mohit1631/Substation-132-33kV-Design/Substation_132_33kV_Design.xlsx

Sheet: Summary
132/33 kV substation: design summary
Links to the calculation sheets. Change Inputs to resize.
Item | Result | Unit
Design load (N-1, with growth) | 49.0 | MVA
Transformers | 2 x 50 MVA, 132/33 kV, YNd11, Z 12.5%
Transformer loading, normal / N-1 now / N-1 design | 41% / 82% / 98%
Rated current 132 kV / 33 kV | 219 A / 875 A
Fault level 132 kV bus | 17.5 | kA
Fault level 33 kV bus (coupler closed / open) | 12.9 / 7.1 | kA
Breaker ratings 132 kV / 33 kV | 31.5 / 25 | kA
Busbars 132 kV / 33 kV | 1250 / 1250 | A
CT ratios: line / transformer HV / incomer / feeder | 600 / 300 / 1200 / 200 | A / 1 A
Arresters 132 kV / 33 kV | 120 / 36 | kV
NGR | 63.5 ohm, 300 A
Earth grid resistance | 0.73 | ohm
Ground potential rise | 9294.209668 | V
Touch voltage: Em vs tolerable | 621 vs 706 | V
Design checks
Check | Status
Transformer N-1 loading at design load <= 100% | OK
Breaker rating >= 132 kV fault level | OK
Breaker rating >= 33 kV fault level | OK
Hand calculation within 5% of pandapower (33 kV) | OK
CT burden / VT burden | OK
OC grading margins >= 0.3 s | OK
Transformer thermal withstand | OK
Earth-fault grading | OK
Earthing: touch voltage | OK
Earthing: step voltage | OK
Earthing: grid resistance <= 1 ohm | OK
Overall | ALL CHECKS PASS
Legend: blue on yellow = input; black = formula; green = link. Grid fault levels, soil resistivity and line data are assumptions.

Sheet: Inputs
Inputs and design basis: 132/33 kV substation
Blue on yellow = editable input. Sheets recalculate from here.
Parameter | Value | Unit | Source / remark
1. System
HV nominal voltage | 132 | kV | Transmission-level supply
HV highest system voltage Um | 145 | kV | IEC 60038 / IEC 60071
LV nominal voltage | 33 | kV
LV highest system voltage Um | 36 | kV
Frequency | 50 | Hz
Grid short-circuit level at 132 kV, maximum (Sk'') | 4000 | MVA | ASSUMPTION (17.5 kA). Obtain from the transmission utility
Grid short-circuit level at 132 kV, minimum | 2500 | MVA | ASSUMPTION (10.9 kA)
IEC 60909 voltage factor c (max) | 1.1 | - | HV system: 1.10
2. Load
Number of 33 kV outgoing feeders | 6 | nos | 3 on each bus section
Design load per feeder | 8 | MVA | Typical 33/11 kV substation feed
Diversity factor | 0.85 | -
Future growth margin | 20% | -
3. Transformer
Number of transformers | 2 | nos | N-1: either one must carry the full design load
Transformer impedance | 12.5 | % | IS 2026 typical for 50 MVA 132/33 kV
OLTC range (HV side) | 10 | +/- % | 16 steps of 1.25%
Load loss at rated MVA | 200 | kW | ASSUMPTION
No-load loss | 30 | kW | ASSUMPTION
33 kV neutral earthing: earth-fault current limit | 300 | A | Resistance earthing through earthing transformer
NGR / earthing transformer short-time rating | 10 | s
4. Equipment design
Utility minimum standard breaking rating, 132 kV | 31.5 | kA | Common utility practice
Utility minimum standard breaking rating, 33 kV | 25 | kA | Common utility practice
Peak factor kappa (ip = kappa x sqrt2 x Ik'') | 1.80 | - | Use 1.8 for HV (X/R high)
Future transformer bays | 1 | nos | 132 kV bus is sized for these
Busbar design margin | 1.25 | -
CT primary margin over rated current | 1.20 | -

Sheet: Transformer
Transformer sizing, ratings and earthing
One 132/33 kV transformer. N-1 means one unit must carry the full 33 kV load.
Parameter | Value | Unit | Source / remark
Load and rating
Connected load | 48.0 | MVA
Peak demand = connected x diversity | 40.8 | MVA
Design load with growth | 49.0 | MVA | Must be carried by one transformer (N-1)
Selected transformer rating | 50.0 | MVA | Next standard size (ONAF rating)
Loading, normal (both in service, load shared) | 40.8%
Loading, N-1 at present peak | 81.6%
Loading, N-1 at design load (with growth) | 97.92% |  | Should stay at or below 100%
Rated current, 132 kV side | 218.7 | A
Rated current, 33 kV side | 874.8 | A
Feeder rated current | 140.0 | A
Impedance and losses
Transformer impedance, pu on own rating | 0.1250 | pu
IEC 60909 correction factor KT = 0.95 c / (1 + 0.6 xT) | 0.972
Copper loss as % (for load flow models) | 0.40 | %
Neutral earthing of the 33 kV system (earthing transformer + NGR)
33 kV phase voltage | 19052.55888 | V
NGR resistance = Vph / IEF | 63.5 | ohm
Earthing transformer short-time rating = Vph x IEF | 5715.767665 | kVA | For the NGR time (10 s). Continuous rating much lower
NGR power during fault | 5.72 | MW
Voltage regulation
OLTC step | 1.25 | % | 16 steps total

Sheet: ShortCircuit
Short-circuit calculation (IEC 60909, per-unit on transformer MVA)
Grid Sk'' already includes c. Z in pu. Cross-checked with pandapower below. Peak and breaker ratings follow.
Parameter | Value | Unit | Source / remark
Per-unit impedances (base = transformer MVA)
Grid impedance at max level = c x MVA_base / Sk'' | 0.0138 | pu
Grid impedance at min level = MVA_base / Sk'' | 0.0200 | pu
Transformer impedance with KT | 0.1215 | pu
Fault levels
Ik'' at 132 kV bus (max) | 17.50 | kA | Sk'' / (sqrt3 x Un)
Ik'' at 132 kV bus (min) | 10.93 | kA
Ik'' at 33 kV bus, coupler closed, both transformers (max) | 12.92 | kA
Ik'' at 33 kV bus, coupler open or one transformer (max) | 7.11 | kA
Ik'' at 33 kV bus, coupler open (min) | 6.03 | kA | c = 1.0 for minimum case
Peak current ip at 132 kV | 44.5 | kA
Peak current ip at 33 kV (coupler closed) | 32.9 | kA
Breaker and busbar rating (smallest standard value, not below utility minimum)
132 kV equipment short-circuit rating (3 s) | 31.5 | kA
33 kV equipment short-circuit rating (3 s) | 25.0 | kA
Utilisation 132 kV (Ik'' / rating) | 55.54115144%
Utilisation 33 kV (Ik'' / rating) | 51.66042206%
Making capacity 132 kV (2.5 x rating) | 78.8 | kA peak
Making capacity 33 kV (2.5 x rating) | 62.5 | kA peak
Check with pandapower (IEC 60909 solver, see notebook)
pandapower: 132 kV bus max | 17.50 | kA | Static value from the study run
pandapower: 33 kV bus, coupler closed, max | 12.92 | kA
pandapower: 33 kV bus, coupler open, max | 7.12 | kA
pandapower: 33 kV bus, coupler open, min | 6.04 | kA
Difference hand vs pandapower, 33 kV closed | -0.03014541024%
Difference hand vs pandapower, 33 kV open | -0.01413506021%
Single-line-to-ground at 132 kV bus (pandapower, with transformer zero-sequence) | 18.6 | kA | Used for earthing design
33 kV earth-fault current (limited by NGR) | 0.30 | kA

Sheet: Equipment
Equipment ratings (per bay type)
Current ratings from transformer and feeder data. Insulation levels per IEC 60071 (Um 145 kV: 650/275 kV; Um 36 kV: 170/70 kV).
Parameter | Value | Unit | Source / remark
Busbars
132 kV busbar current rating = (transformers + future) x I_hv x margin | 1250 | A | Tubular aluminium busbar
33 kV busbar current rating = I_lv x margin | 1250 | A
Circuit breakers
132 kV line / bus-section breaker current | 1250 | A | Line carries both transformers
132 kV transformer breaker current | 1250 | A | Smallest 132 kV standard is 1250 A
33 kV incomer / coupler breaker current | 1250 | A
33 kV feeder breaker current | 630 | A
132 kV breaker short-circuit rating | 31.5 | kA | SF6, 3 s
33 kV breaker short-circuit rating | 25.0 | kA | Vacuum, 3 s
Insulation and arresters
132 kV lightning impulse withstand (LIWL) | 650 | kV | IEC 60071-1 for Um 145 kV
132 kV power-frequency withstand (1 min) | 275 | kV
33 kV lightning impulse withstand (LIWL) | 170 | kV | IEC 60071-1 for Um 36 kV
33 kV power-frequency withstand (1 min) | 70 | kV
132 kV arrester rated voltage = 0.8 x Um (effectively earthed) | 120 | kV | Next multiple of 6: 120 kV
33 kV arrester rated voltage = Um (resistance earthed, not effectively earthed) | 36 | kV | 36 kV
Current transformers (secondary 1 A at 132 kV and 33 kV)
CT ratio, 132 kV line bay and bus section | 600 | A / 1 A
CT ratio, transformer HV bay | 300 | A / 1 A
CT ratio, 33 kV incomer and bus coupler | 1200 | A / 1 A
CT ratio, 33 kV feeder | 200 | A / 1 A
CT ratio, earthing transformer neutral | 400 | A / 1 A
CT short-time current (3 s) | 31.5 | kA | same as breaker (132 kV); 33 kV CTs use the 33 kV rating
CT knee-point voltage for the transformer differential (HV side)
CT secondary resistance Rct | 3.0 | ohm | Typical 1 A PS class
Lead resistance (loop) | 2.2 | ohm | About 150 m of 2.5 mm² each way
Relay burden | 0.05 | ohm | Numerical relay
Through-fault current at HV side (33 kV fault, closed coupler) | 3228.776379 | A | Maximum external fault referred to HV
Secondary current at that fault | 10.8 | A
Required Vk = 2 x Is x (Rct + RL + Rr) | 113.0071733 | V | K = 2 stability factor
Selected standard Vk | 200 | V | Specify class PS
Voltage transformers
CVT metering core (0.2) burden rating | 50 | VA | 132 kV
CVT protection core (3P) burden rating | 100 | VA
Metering core connected burden (meters 8 VA + transducers 6 VA + cable 2 VA) | 16 | VA | Should be 25-100% of rating
Protection core connected burden (relays 10 VA + sync 5 VA + cable 15 VA) | 30 | VA | Should be 25-100% of rating
Metering core utilisation | 32%
Protection core utilisation | 30%
Burden check (25% to 100%) | OK

Sheet: Protection
Protection settings and grading
IEC Normal Inverse: t = TMS x 0.14 / ((I/Is)^0.02 - 1). Settings are proposed starting values for a relay-coordination study.
Parameter | Value | Unit | Source / remark
33 kV feeder (50/51, 50N/51N)
Feeder CT primary | 200 | A | From Equipment
51 pickup | 175 | A | 1.25 x feeder current
51 TMS | 0.10
50 instantaneous | 1600 | A | 8 x CT
33 kV incomer (51)
51 pickup | 1050 | A | 1.2 x rated
51 TMS | 0.20
132 kV transformer backup (51)
51 pickup = 1.2 x rated, rounded up to 10 A | 270 | A
51 TMS | 0.30
50 instantaneous = 1.3 x max 33 kV fault referred to HV | 4200 | A | Must not operate for 33 kV faults
Grading at 33 kV bus faults (feeder IDMT only; incomers carry half when coupler closed)
Fault current: max, coupler closed | 12915.10551 | A
Fault current: one transformer in service (N-1) | 7113.99429 | A
Fault current: min, coupler open | 6032.918173 | A
Feeder time, max | 0.156 | s
Incomer time, max | 0.757 | s | Half of the fault current
HV 51 time, max | 1.153 | s
Margin incomer over feeder, max | 0.601 | s | Need at least 0.3 s
Margin HV over incomer, max | 0.397 | s | Need at least 0.3 s
Feeder time, N-1 | 0.182 | s
Incomer time, N-1 | 0.718 | s
HV 51 time, N-1 | 1.093 | s
Margin incomer over feeder, N-1 | 0.536 | s
Margin HV over incomer, N-1 | 0.375 | s
Grading check (all margins >= 0.3 s) | OK
N-1 through-fault current in per unit of rated | 8.1 | pu | IEC 60076-5 allows 2 s at 1/Z
Relay clearing time at that fault | 1.09 | s | Must be below 2 s
Thermal withstand check | OK
33 kV earth fault (NGR-limited)
Feeder 51N pickup | 30 | A | 10% of NGR current
Feeder 51N TMS | 0.10
Neutral (earthing transformer) 51N pickup | 60 | A | 20% of NGR current
Neutral 51N TMS | 0.20
Feeder 51N time at NGR current | 0.297 | s
Neutral 51N time at NGR current | 0.856 | s
Margin | 0.559 | s | Need at least 0.3 s
Earth-fault grading check | OK
Transformer differential (87T, numerical relay)
HV secondary current at rated load | 0.729 | A
LV secondary current at rated load | 0.729 | A
CT mismatch ratio | 1.000 |  | Close to 1.0: relay ratio compensation is small
Minimum pickup (pu of rated) | 0.20 | pu
Slope 1 (up to 2 pu) | 25 | %
Slope 2 | 50 | %
2nd harmonic restraint (inrush) | 15 | %
5th harmonic restraint (over-excitation) | 35 | %
Unrestrained high-set | 8 | pu | Above inrush peak not blocked by harmonics
Line distance protection (21) example: 30 km line, 20 km adjacent line
Line positive-sequence resistance | 0.14 | ohm/km | ACSR Panther assumption
Line positive-sequence reactance | 0.40 | ohm/km
Protected line length | 30 | km
Adjacent line length | 20 | km
Protected line impedance (primary) | 12.71 | ohm
Adjacent line impedance (primary) | 8.48 | ohm
Primary-to-secondary factor = CT ratio / VT ratio | 0.500
Zone 1 reach, 80% (instantaneous) | 5.09 | ohm sec
Zone 2 reach, 120% of line (0.35 s) | 7.63 | ohm sec
Zone 3 reach, line + 120% adjacent (0.8 s) | 11.44 | ohm sec
High-impedance busbar protection (87B), 132 kV
Maximum through-fault current | 17495.4627 | A
Secondary current | 29.2 | A
CT Rct | 4 | ohm
Lead resistance (loop) | 2 | ohm
Stability voltage setting Vs = Is x (Rct + RL) | 174.954627 | V
Required CT knee-point voltage >= 2 x Vs | 349.9092541 | V

Sheet: Earthing
Earthing grid design (IEEE Std 80 method)
Soil resistivity is an ASSUMPTION: a Wenner survey of the site is mandatory before construction.
Parameter | Value | Unit | Source / remark
Inputs
Grid length | 70 | m | Switchyard + control building area
Grid width | 60 | m
Soil resistivity | 100 | ohm.m | ASSUMPTION (survey needed)
Surface layer resistivity (crushed rock) | 3000 | ohm.m
Surface layer thickness | 0.15 | m
Burial depth of grid | 0.60 | m
Maximum earth-fault current 3I0 (design value) | 20 | kA | Study value 18.6 kA at 132 kV bus, rounded up
Current division factor Sf | 0.60 | - | Share flowing into the grid; rest returns via earth wires and neutrals
Fault clearing time | 1 | s | Backup clearing time, conservative
System X/R at fault | 20 | -
Material constant Kf (steel 1020) | 15.95 | - | IEEE 80 Table 2
Conductor spacing | 5 | m | Chosen to pass the touch-voltage check
Number of earth rods | 40 | nos | On the perimeter and at corners
Rod length | 3 | m
Flat conductor width | 75 | mm
Flat conductor thickness | 12 | mm | Mild steel flat, galvanised
Conductor
Minimum conductor area = If x Kf x sqrt(tf) x 0.5067 | 161.6 | mm²
Selected flat area | 900 | mm²
Conductor check | OK (with 2x margin for corrosion)
Geometry
Area | 4200 | m²
Conductors along width direction | 15 | nos
Conductors along length direction | 13 | nos
Total horizontal conductor length | 1810 | m
Perimeter | 260 | m
Total rod length | 120 | m
Total buried conductor length | 1930 | m
Equivalent conductor diameter = 2(w+t)/pi | 0.0554 | m
Resistance and potential rise
Grid resistance Rg (Sverak) | 0.728 | ohm | Target at or below 1 ohm
DC offset time constant Ta = X/R / (2 pi f) | 0.0637 | s
Decrement factor Df | 1.064
Grid current Ig = Sf x If x Df | 12763.94373 | A
Ground potential rise GPR = Ig x Rg | 9294.209668 | V
Tolerable voltages (70 kg body)
Surface layer factor Cs | 0.777
Tolerable touch voltage | 705.8961538 | V
Tolerable step voltage | 2352.584615 | V
Mesh and step voltage
na = 2 Lc / Lp | 13.92
nb = sqrt(Lp / (4 sqrt(A))) | 1.00
n = na x nb (rectangular grid) | 13.94
Kh = sqrt(1 + h / 1 m) | 1.265
Km | 0.359 |  | Kii = 1 (rods on perimeter and corners)
Ki = 0.644 + 0.148 n | 2.708
Effective length for mesh LM | 2000.763793 | m
Mesh (touch) voltage Em = rho Km Ki Ig / LM | 620.8574801 | V
Ks | 0.386
Effective length for step LS = 0.75 Lc + 0.85 LR | 1459.5 | m
Step voltage Es = rho Ks Ki Ig / LS | 913.4351816 | V
Checks
Touch voltage check (Em <= tolerable) | OK
Step voltage check (Es <= tolerable) | OK
Grid resistance check (<= 1 ohm) | OK
GPR above 5 kV: telecom and SCADA circuits need isolation | YES: use isolation / optical fibre
Sensitivity to soil resistivity (grid as designed). Static values from the Python study.
Soil resistivity (ohm.m) | Rg (ohm) | GPR (V) | Em (V) | Tolerable touch (V) | Step (V) | Result
50 | 0.36 | 4647.104834 | 310.42874 | 703.1788462 | 456.7175908 | PASS
100 | 0.73 | 9294.209668 | 620.8574801 | 705.8961538 | 913.4351816 | PASS
150 | 1.09 | 13941.3145 | 931.2862201 | 708.6134615 | 1370.152772 | FAIL
200 | 1.46 | 18588.41934 | 1241.71496 | 711.3307692 | 1826.870363 | FAIL
300 | 2.18 | 27882.629 | 1862.57244 | 716.7653846 | 2740.305545 | FAIL
Result: the grid passes up to about 100 ohm.m. Above about 150 ohm.m touch voltage fails: add rods, reduce spacing, or use deeper electrodes. This is why the soil survey matters.

Sheet: BOM
Major equipment list (no prices)
Quantities from the single line diagram. Edit counts if you change the layout.
Item | Description | Qty
Power transformer | 132/33 kV, 50 MVA ONAN/ONAF, YNd11, Z = 12.5%, OLTC +/-10% | 2
132 kV SF6 circuit breaker | 145 kV, 1250 A, 31.5 kA / 3 s (line, bus section), 1250 A (transformer) | 5
132 kV isolator (double break), line isolators with earth switch | 145 kV, 1250 A, 31.5 kA | 8
132 kV CT (3 phase sets) | 600/1 (line, bus section), 300/1 (transformer), 4-5 cores | 5
132 kV capacitor voltage transformer (3 phase sets) | 132/V3 kV : 110/V3 V, 0.2 / 3P / 3P | 4
132 kV surge arrester (3 phase sets) | 120 kV, 10 kA, station class | 4
132 kV busbar | Tubular, 1250 A, 2 sections | 2
33 kV vacuum circuit breaker (incomer and coupler) | 36 kV, 1250 A, 25 kA / 3 s | 3
33 kV vacuum circuit breaker (feeder) | 36 kV, 630 A, 25 kA / 3 s | 6
33 kV vacuum circuit breaker (earthing transformer) | 36 kV, 630 A, 25 kA / 3 s | 2
33 kV isolator (incomers, coupler, feeders, earthing transformers, PT) | 36 kV, 1250 A | 14
33 kV CT sets | 1200/1 (incomer, coupler), 200/1 (feeder), 400/1 (neutral) | 11
33 kV voltage transformer (3 phase sets) | 33/V3 kV : 110/V3 V, 0.5 / 3P | 2
33 kV surge arrester | 36 kV, 10 kA | 8
Earthing transformer (zig-zag) with 415 V aux winding | 5,716 kVA for 10 s, 300 A | 2
Neutral earthing resistor | 63.5 ohm, 300 A, 10 s | 2
Numerical protection relays (approximate count) | Line (21), transformer (87T, 51), feeder (50/51), bus (87B), 25, 50BF | 19
Earthing grid | 70 x 60 m, 75x12 mm MS flat at 5 m spacing, 40 rods x 3 m | 1
DC system | 110 V, 2 x 100% battery banks and chargers | 2

Sheet: Std
Standard ratings (edit if your vendor differs)
Transformer (MVA) | 132 kV breaking (kA) | 33 kV breaking (kA) | 132 kV equipment current (A) | 33 kV equipment current (A) | CT primary (A) | CT knee-point Vk (V)
20 | 25 | 16 | 1250 | 630 | 50 | 100
31.5 | 31.5 | 25 | 2000 | 1250 | 100 | 200
40 | 40 | 31.5 | 3150 | 2000 | 150 | 300
50 |  | 40 |  | 2500 | 200 | 400
63 |  |  |  | 3150 | 300 | 600
80 |  |  |  |  | 400 | 800
100 |  |  |  |  | 600 | 1000
 |  |  |  |  | 800
 |  |  |  |  | 1000
 |  |  |  |  | 1200
 |  |  |  |  | 1600
 |  |  |  |  | 2000
