mohit1631/Substation-132-33kV-Design/Substation_SLD.dxf

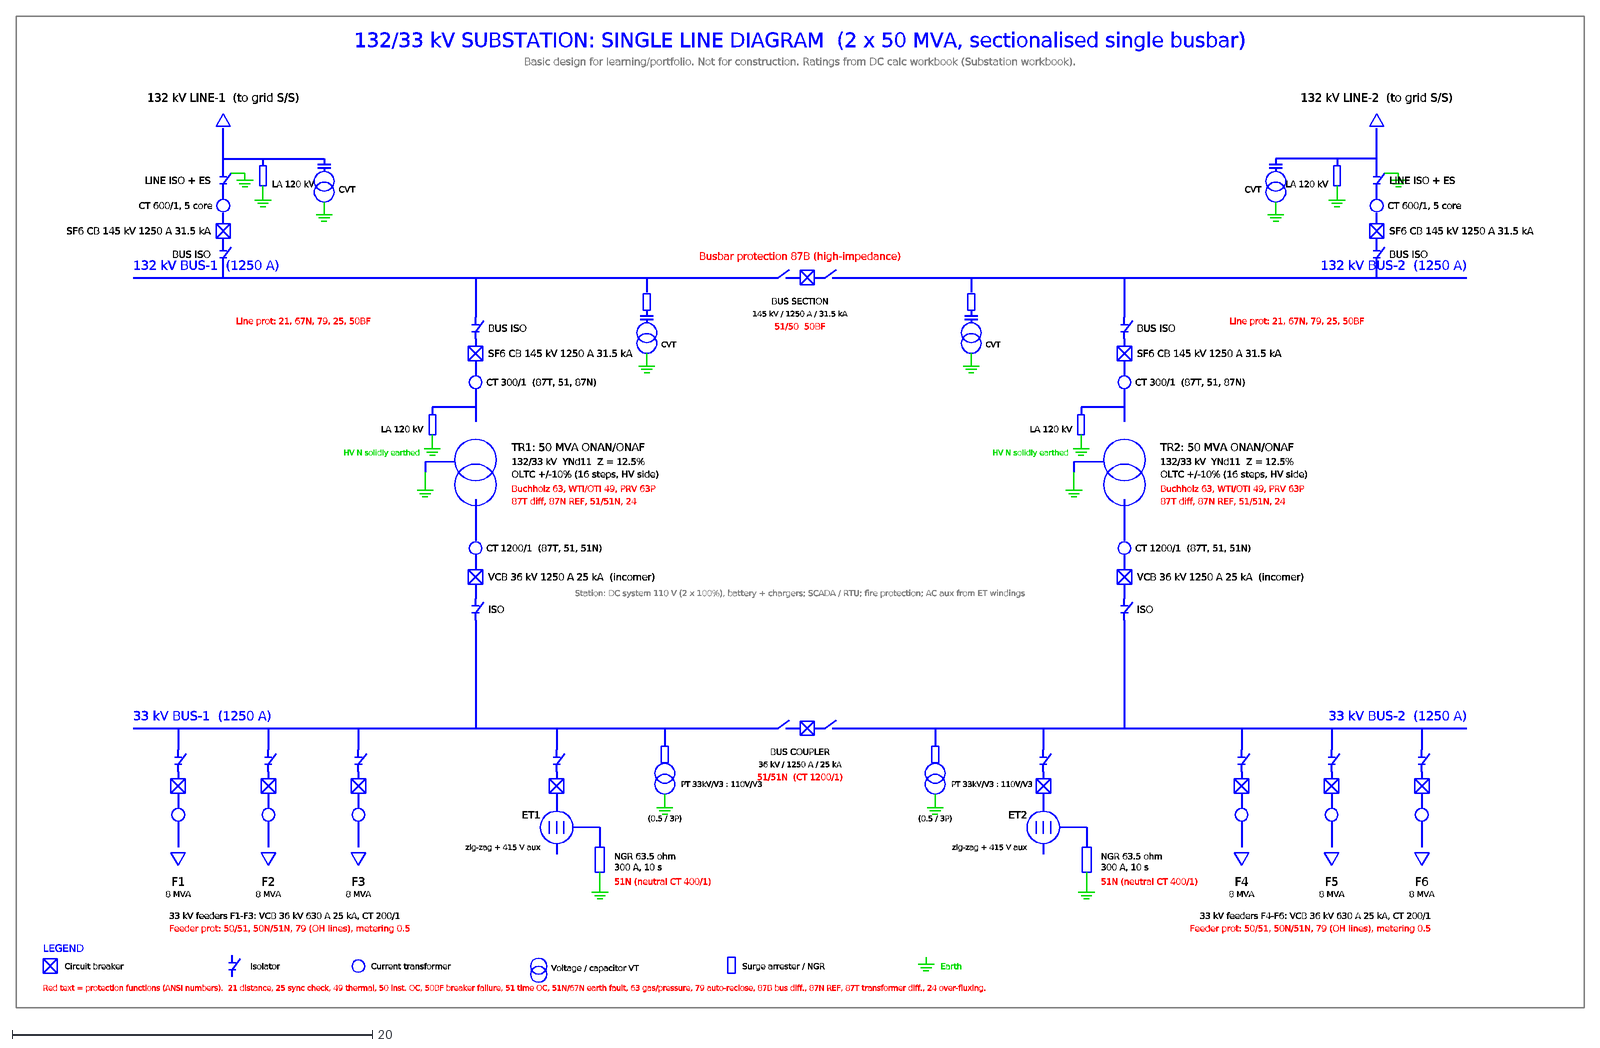
[picture p6: CAD file, 2026-10-28]
Substation_SLD.dxf
132/33 kV SUBSTATION: SINGLE LINE DIAGRAM (2 x 50 MVA, sectionalised single busbar)
Basic design for learning/portfolio. Not for construction. Ratings from DC calc workbook (Substation workbook).
132 kV BUS-1 (1250 A)
132 kV BUS-2 (1250 A)
BUS SECTION
145 kV / 1250 A / 31.5 kA
51/50 50BF
BUS ISO
SF6 CB 145 kV 1250 A 31.5 kA
CT 600/1, 5 core
LINE ISO + ES
LA 120 kV
CVT
132 kV LINE-1 (to grid S/S)
132 kV LINE-2 (to grid S/S)
Line prot: 21, 67N, 79, 25, 50BF
CT 300/1 (87T, 51, 87N)
TR1: 50 MVA ONAN/ONAF
132/33 kV YNd11 Z = 12.5%
OLTC +/-10% (16 steps, HV side)
Buchholz 63, WTI/OTI 49, PRV 63P
87T diff, 87N REF, 51/51N, 24
HV N solidly earthed
CT 1200/1 (87T, 51, 51N)
VCB 36 kV 1250 A 25 kA (incomer)
ISO
TR2: 50 MVA ONAN/ONAF
33 kV BUS-1 (1250 A)
33 kV BUS-2 (1250 A)
BUS COUPLER
36 kV / 1250 A / 25 kA
51/51N (CT 1200/1)
F1
8 MVA
F2
F3
F4
F5
F6
33 kV feeders F1-F3: VCB 36 kV 630 A 25 kA, CT 200/1
33 kV feeders F4-F6: VCB 36 kV 630 A 25 kA, CT 200/1
Feeder prot: 50/51, 50N/51N, 79 (OH lines), metering 0.5
ET1
NGR 63.5 ohm
300 A, 10 s
zig-zag + 415 V aux
51N (neutral CT 400/1)
ET2
PT 33kV/V3 : 110V/V3
(0.5 / 3P)
Busbar protection 87B (high-impedance)
Station: DC system 110 V (2 x 100%), battery + chargers; SCADA / RTU; fire protection; AC aux from ET windings
LEGEND
Circuit breaker
Isolator
Current transformer
Voltage / capacitor VT
Surge arrester / NGR
Earth
Red text = protection functions (ANSI numbers). 21 distance, 25 sync check, 49 thermal, 50 inst. OC, 50BF breaker failure, 51 time OC, 51N/67N earth fault, 63 g
